EwanRedgrift/Timed-Piezo-Driver/hardware/layout/Back.jpeg

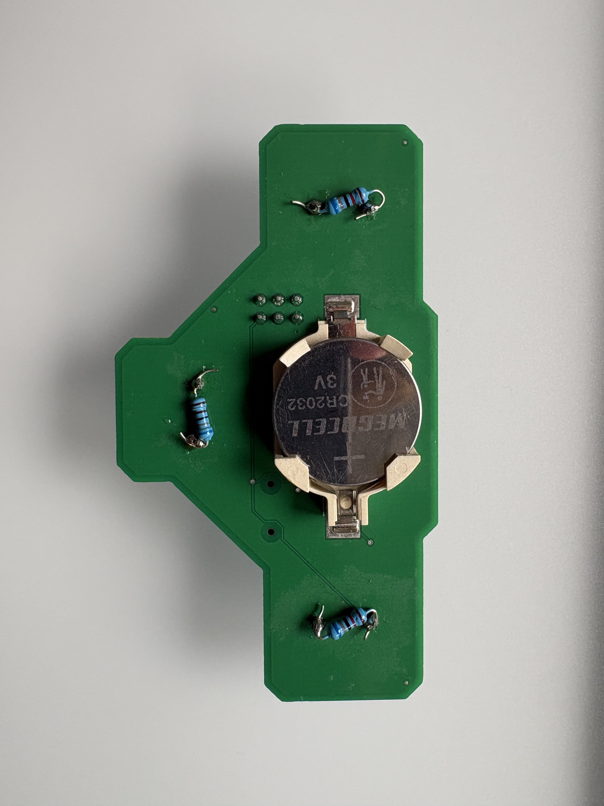
hardware/layout/Back.jpeg
