EwanRedgrift/Timed-Piezo-Driver/hardware/layout/Front.jpeg

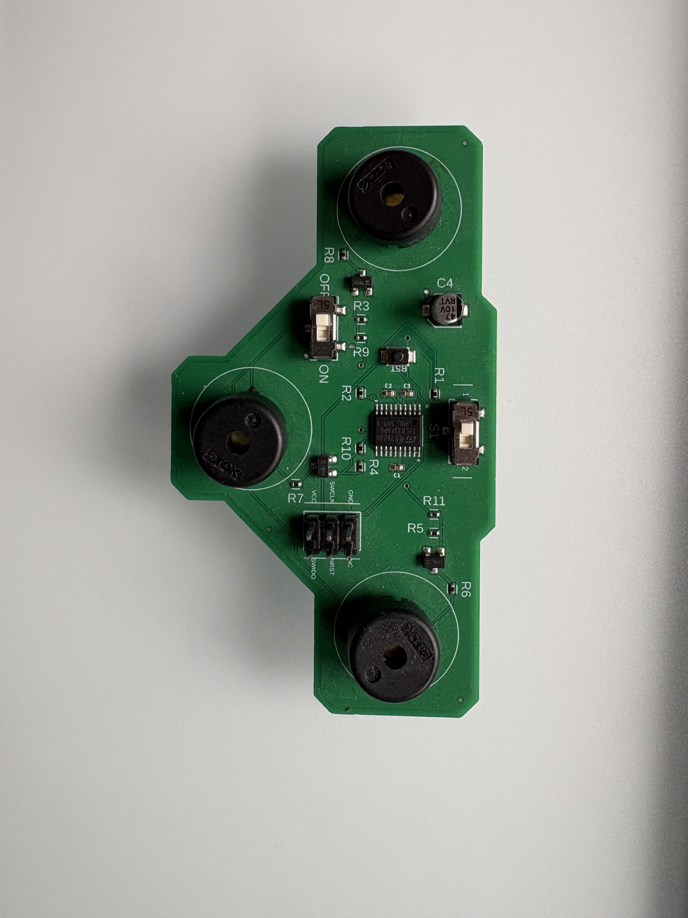
hardware/layout/Front.jpeg
