EwanRedgrift/Timed-Piezo-Driver/hardware/schematic/Schematic.png

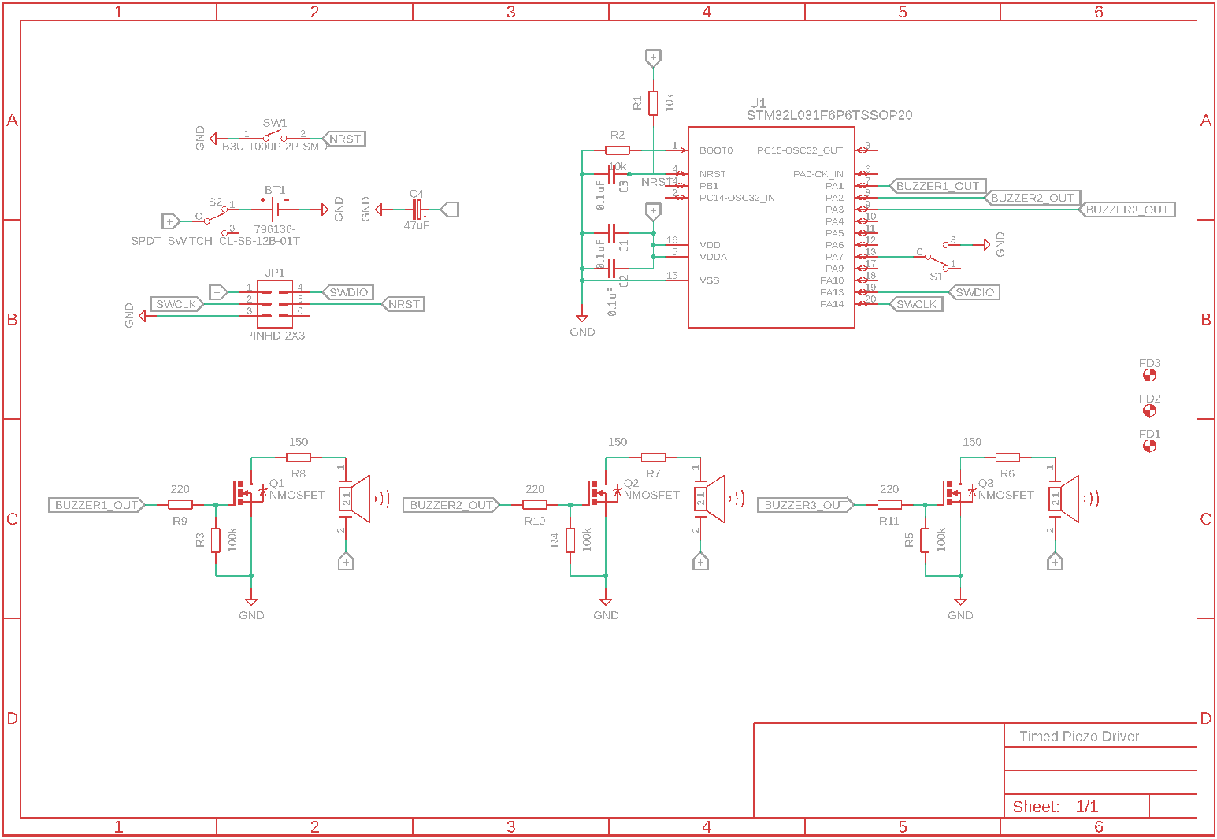
hardware/schematic/Schematic.png
