EwanRedgrift/Timed-Piezo-Driver/firmware/Core/Src/main.c

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


/* Includes ------------------------------------------------------------------*/
#include "main.h"

/* USER CODE BEGIN Includes */
#include "notes.h"
/* USER CODE END Includes */

/* USER CODE BEGIN PTD */

typedef struct {
  uint16_t freq_v1;     /* Voice 1 (PA1), Hz, 0 = rest */
  uint16_t freq_shared; /* Voices 2 & 3 (PA2 & PA3), Hz, 0 = rest */
  uint16_t duration;    /* Note length in milliseconds */
} SongStep;

typedef struct {
  const SongStep *steps;
  uint32_t length;      /* Number of steps */
} Song;

/* USER CODE END PTD */

/* USER CODE BEGIN PD */

/*
 * Time to sleep between songs, in seconds.
 * Change these two values to change the delay.
 */
#define SLEEP_LONG_SECONDS    (60U * 60U) /* Switch in the "long" position  */
#define SLEEP_SHORT_SECONDS   (10U * 60U)  /* Switch in the "short" position */

/* Pin level that selects the long sleep time (GPIO_PIN_SET or GPIO_PIN_RESET) */
#define SWITCH_LONG_STATE     GPIO_PIN_SET

/* Fallback pin definitions if SWITCH_Input is not labelled in CubeMX/main.h */
#ifndef SWITCH_Input_Pin
#define SWITCH_Input_Pin        GPIO_PIN_7
#define SWITCH_Input_GPIO_Port  GPIOA
#endif

/*
 * RTC prescalers. The L031 LSI is nominally 38 kHz, so
 * 38000 / ((124 + 1) * (303 + 1)) = 1 Hz. LSI is not very accurate
 * (roughly +/-30%), so sleep times are approximate.
 */
#define RTC_ASYNCH_PREDIV     124U
#define RTC_SYNCH_PREDIV      303U

#define NOTE_GAP_MS           20U /* Short silence between notes so they don't blur */

/* USER CODE END PD */

/* USER CODE BEGIN PM */
#define ARRAY_SIZE(x)         (sizeof(x) / sizeof((x)[0]))
/* USER CODE END PM */

RTC_HandleTypeDef hrtc;
TIM_HandleTypeDef htim2;
TIM_HandleTypeDef htim21;
TIM_HandleTypeDef htim22; /* Not used, but referenced by TIM22_IRQHandler in stm32l0xx_it.c */

/* USER CODE BEGIN PV */
static uint32_t random_state = 1;

static const SongStep solo_future[] = {
  { NOTE_G4,  NOTE_G4,  500  },
  { NOTE_F4,  NOTE_F4,  800  },
  { NOTE_F4,  NOTE_C5,  250  },
  { NOTE_DS4, NOTE_DS4, 250  },
  { NOTE_G4,  NOTE_G4,  500  },
  { NOTE_F4,  NOTE_F4,  800  },
  { NOTE_F4,  NOTE_C5,  250  },
  { NOTE_DS4, NOTE_DS4, 250  },
  { NOTE_G4,  NOTE_G4,  500  },
  { NOTE_GS4, NOTE_GS4, 800  },
  { NOTE_GS4, NOTE_C5,  250  },
  { NOTE_DS4, NOTE_DS4, 250  },
  { NOTE_G4,  NOTE_G4,  1300 },
  { NOTE_G4,  NOTE_C5,  250  },
  { NOTE_DS4, NOTE_DS4, 250  },
};

static const SongStep rick_ross_stay_schemin[] = {
  /* First phrase (G minor) */
  { NOTE_G3,  NOTE_G4,  167  },
  { NOTE_G3,  NOTE_AS4, 167  },
  { NOTE_G3,  NOTE_F4,  167  },
  { NOTE_G3,  NOTE_D4,  500  },
  { NOTE_G3,  NOTE_F4,  667  },
  { NOTE_G3,  NOTE_A4,  1000 },

  /* Second phrase (Bb major) */
  { NOTE_AS3, NOTE_G4,  167  },
  { NOTE_AS3, NOTE_AS4, 167  },
  { NOTE_AS3, NOTE_F4,  167  },
  { NOTE_AS3, NOTE_D4,  500  },
  { NOTE_AS3, NOTE_F4,  667  },
  { NOTE_AS3, NOTE_A4,  667  },
  { NOTE_AS3, NOTE_AS4, 333  },

  /* Third section, beats 9-13 (F minor chord) */
  { NOTE_F3,  NOTE_G4,  167  },
  { NOTE_F3,  NOTE_AS4, 167  },
  { NOTE_F3,  NOTE_F4,  167  },
  { NOTE_F3,  NOTE_D4,  500  },
  { NOTE_F3,  NOTE_F4,  667  },
  { NOTE_F3,  NOTE_A4,  1000 },

  /* Fourth section, beats 13-17 (C and D chords) */
  { NOTE_C3,  NOTE_G4,  167  },
  { NOTE_C3,  NOTE_AS4, 167  },
  { NOTE_C3,  NOTE_F4,  167  },
  { NOTE_C3,  NOTE_D4,  500  },
  { NOTE_C3,  NOTE_F4,  667  },
  { NOTE_D3,  NOTE_A4,  667  },
  { NOTE_D3,  NOTE_AS4, 333  },
};

/* All songs available to the random player. Add new songs here. */
static const Song songs[] = {
  { solo_future,            ARRAY_SIZE(solo_future)            },
  { rick_ross_stay_schemin, ARRAY_SIZE(rick_ross_stay_schemin) },
};
/* USER CODE END PV */

void SystemClock_Config(void);
static void MX_GPIO_Init(void);
static void MX_TIM2_Init(void);
static void MX_TIM21_Init(void);
static void MX_RTC_Init(void);
/* USER CODE BEGIN PFP */
static void Play_Tone(TIM_HandleTypeDef *htim, uint32_t channel, uint16_t freq);
static void Play_Shared_Tone(uint16_t freq);
static void Play_Custom_Song(const Song *song);
static uint32_t Random_Number(void);
static void Play_Random_Song(void);
static uint32_t Get_Sleep_Seconds(void);
static void Enter_Stop_Mode(uint32_t seconds);
/* USER CODE END PFP */

/* USER CODE BEGIN 0 */

/**
  * @brief  Set the frequency of one PWM channel (50% duty cycle).
  * @param  htim    Timer handle
  * @param  channel TIM_CHANNEL_x
  * @param  freq    Frequency in Hz, 0 silences the channel
  */
static void Play_Tone(TIM_HandleTypeDef *htim, uint32_t channel, uint16_t freq)
{
  if (freq == 0)
  {
    __HAL_TIM_SET_COMPARE(htim, channel, 0);
    return;
  }

  uint32_t timer_freq = SystemCoreClock / (htim->Init.Prescaler + 1);
  uint32_t arr = (timer_freq / freq) - 1;

  __HAL_TIM_SET_AUTORELOAD(htim, arr);
  __HAL_TIM_SET_COMPARE(htim, channel, (arr + 1) / 2);
}

/**
  * @brief  Set the frequency of buzzers 2 & 3 (both share TIM21).
  * @param  freq Frequency in Hz, 0 silences both channels
  */
static void Play_Shared_Tone(uint16_t freq)
{
  if (freq == 0)
  {
    __HAL_TIM_SET_COMPARE(&htim21, TIM_CHANNEL_1, 0);
    __HAL_TIM_SET_COMPARE(&htim21, TIM_CHANNEL_2, 0);
    return;
  }

  uint32_t timer_freq = SystemCoreClock / (htim21.Init.Prescaler + 1);
  uint32_t arr = (timer_freq / freq) - 1;

  __HAL_TIM_SET_AUTORELOAD(&htim21, arr);
  __HAL_TIM_SET_COMPARE(&htim21, TIM_CHANNEL_1, (arr + 1) / 2);
  __HAL_TIM_SET_COMPARE(&htim21, TIM_CHANNEL_2, (arr + 1) / 2);
}

/**
  * @brief  Play a song (blocking).
  * @param  song Song to play
  */
static void Play_Custom_Song(const Song *song)
{
  for (uint32_t i = 0; i < song->length; i++)
  {
    Play_Tone(&htim2, TIM_CHANNEL_2, song->steps[i].freq_v1);
    Play_Shared_Tone(song->steps[i].freq_shared);

    HAL_Delay(song->steps[i].duration);

    Play_Tone(&htim2, TIM_CHANNEL_2, 0);
    Play_Shared_Tone(0);
    HAL_Delay(NOTE_GAP_MS);
  }
}

/**
  * @brief  Xorshift32 pseudo-random number generator.
  */
static uint32_t Random_Number(void)
{
  random_state ^= random_state << 13;
  random_state ^= random_state >> 17;
  random_state ^= random_state << 5;

  if (random_state == 0)
  {
    random_state = 1;
  }

  return random_state;
}

/**
  * @brief  Pick one of the songs at random and play it (blocking).
  */
static void Play_Random_Song(void)
{
  Play_Custom_Song(&songs[Random_Number() % ARRAY_SIZE(songs)]);
}

/**
  * @brief  Read the sleep-time switch.
  * @retval Sleep time in seconds
  */
static uint32_t Get_Sleep_Seconds(void)
{
  if (HAL_GPIO_ReadPin(SWITCH_Input_GPIO_Port, SWITCH_Input_Pin) == SWITCH_LONG_STATE)
  {
    return SLEEP_LONG_SECONDS;
  }

  return SLEEP_SHORT_SECONDS;
}

/**
  * @brief  Sleep in STOP mode until the RTC wake-up timer expires.
  * @param  seconds Approximate sleep time (1 to 65536)
  */
static void Enter_Stop_Mode(uint32_t seconds)
{
  if (seconds < 1U)
  {
    seconds = 1U;
  }

  /* CK_SPRE is ~1 Hz, the counter counts (value + 1) ticks */
  if (HAL_RTCEx_SetWakeUpTimer_IT(&hrtc, seconds - 1U,
                                  RTC_WAKEUPCLOCK_CK_SPRE_16BITS) != HAL_OK)
  {
    Error_Handler();
  }

  /* Stop SysTick so it doesn't wake the MCU */
  HAL_SuspendTick();

  HAL_PWR_EnterSTOPMode(PWR_LOWPOWERREGULATOR_ON, PWR_STOPENTRY_WFI);

  /* Execution resumes here after the RTC wakes the MCU */
  HAL_ResumeTick();

  /* Clocks are reset on STOP exit, restore the configuration */
  SystemClock_Config();

  HAL_RTCEx_DeactivateWakeUpTimer(&hrtc);
}

/* USER CODE END 0 */

/**
  * @brief  The application entry point.
  * @retval int
  */
int main(void)
{
  /* MCU Configuration--------------------------------------------------------*/

  /* Reset of all peripherals, Initializes the Flash interface and the Systick. */
  HAL_Init();

  /* Configure the system clock */
  SystemClock_Config();

  /* Initialize all configured peripherals */
  MX_GPIO_Init();
  MX_TIM2_Init();
  MX_TIM21_Init();
  MX_RTC_Init();
  /* USER CODE BEGIN 2 */

  /* Start PWM on all 3 buzzer channels */
  if (HAL_TIM_PWM_Start(&htim2, TIM_CHANNEL_2) != HAL_OK)
  {
    Error_Handler();
  }
  if (HAL_TIM_PWM_Start(&htim21, TIM_CHANNEL_1) != HAL_OK)
  {
    Error_Handler();
  }
  if (HAL_TIM_PWM_Start(&htim21, TIM_CHANNEL_2) != HAL_OK)
  {
    Error_Handler();
  }

  /*
   * Seed the pseudo-random generator. These values are fairly similar on
   * every power-up, so the first song may often be the same.
   */
  random_state = HAL_GetTick() ^ RTC->SSR ^ SysTick->VAL;
  if (random_state == 0)
  {
    random_state = 1;
  }

  /* USER CODE END 2 */

  /* Infinite loop */
  /* USER CODE BEGIN WHILE */
  while (1)
  {
    /* USER CODE END WHILE */

    /* USER CODE BEGIN 3 */
    Play_Random_Song();

    /* The switch is read once per cycle, right before sleeping */
    Enter_Stop_Mode(Get_Sleep_Seconds());
  }
  /* USER CODE END 3 */
}

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
