EwanRedgrift/Timed-Piezo-Driver/firmware/Core/Inc/main.h

#define BUZZER1_Output_Pin GPIO_PIN_1
#define BUZZER1_Output_GPIO_Port GPIOA
#define BUZZER2_Output_Pin GPIO_PIN_2
#define BUZZER2_Output_GPIO_Port GPIOA
#define BUZZER3_Output_Pin GPIO_PIN_3
#define BUZZER3_Output_GPIO_Port GPIOA
#define SWITCH_Input_Pin GPIO_PIN_7
#define SWITCH_Input_GPIO_Port GPIOA
