EwanRedgrift/Timed-Piezo-Driver/(commit log)

2026-09-07 Create schematic
2026-10-01 Schematic photo
2026-10-31 Add STM32L031 buzzer firmware
    [main.c, main.h, notes.h, peizo.ioc]
2026-10-31 Update README with project details and instructions
    Added detailed project description, functionality, and hardware specifications for the Timed Piezo Driver.
2026-10-31 Change device recording links to GitHub assets
    Updated device recording links to point to GitHub assets.
