EwanRedgrift/Timed-Piezo-Driver/(notices)

Notices in the files:
firmware/Core/Inc/main.h:
Copyright (c) 2026 STMicroelectronics.
All rights reserved.
This software is licensed under terms that can be found in the LICENSE file
firmware/Core/Src/main.c:
See the LICENSE file in the root of this project.
